BaktiyarBr/ElectronyConstructor/CosmosBoard/CosmosBoard.kicad_pcb

## KiCad design CosmosBoard/CosmosBoard.kicad_pcb (2024-06-29)

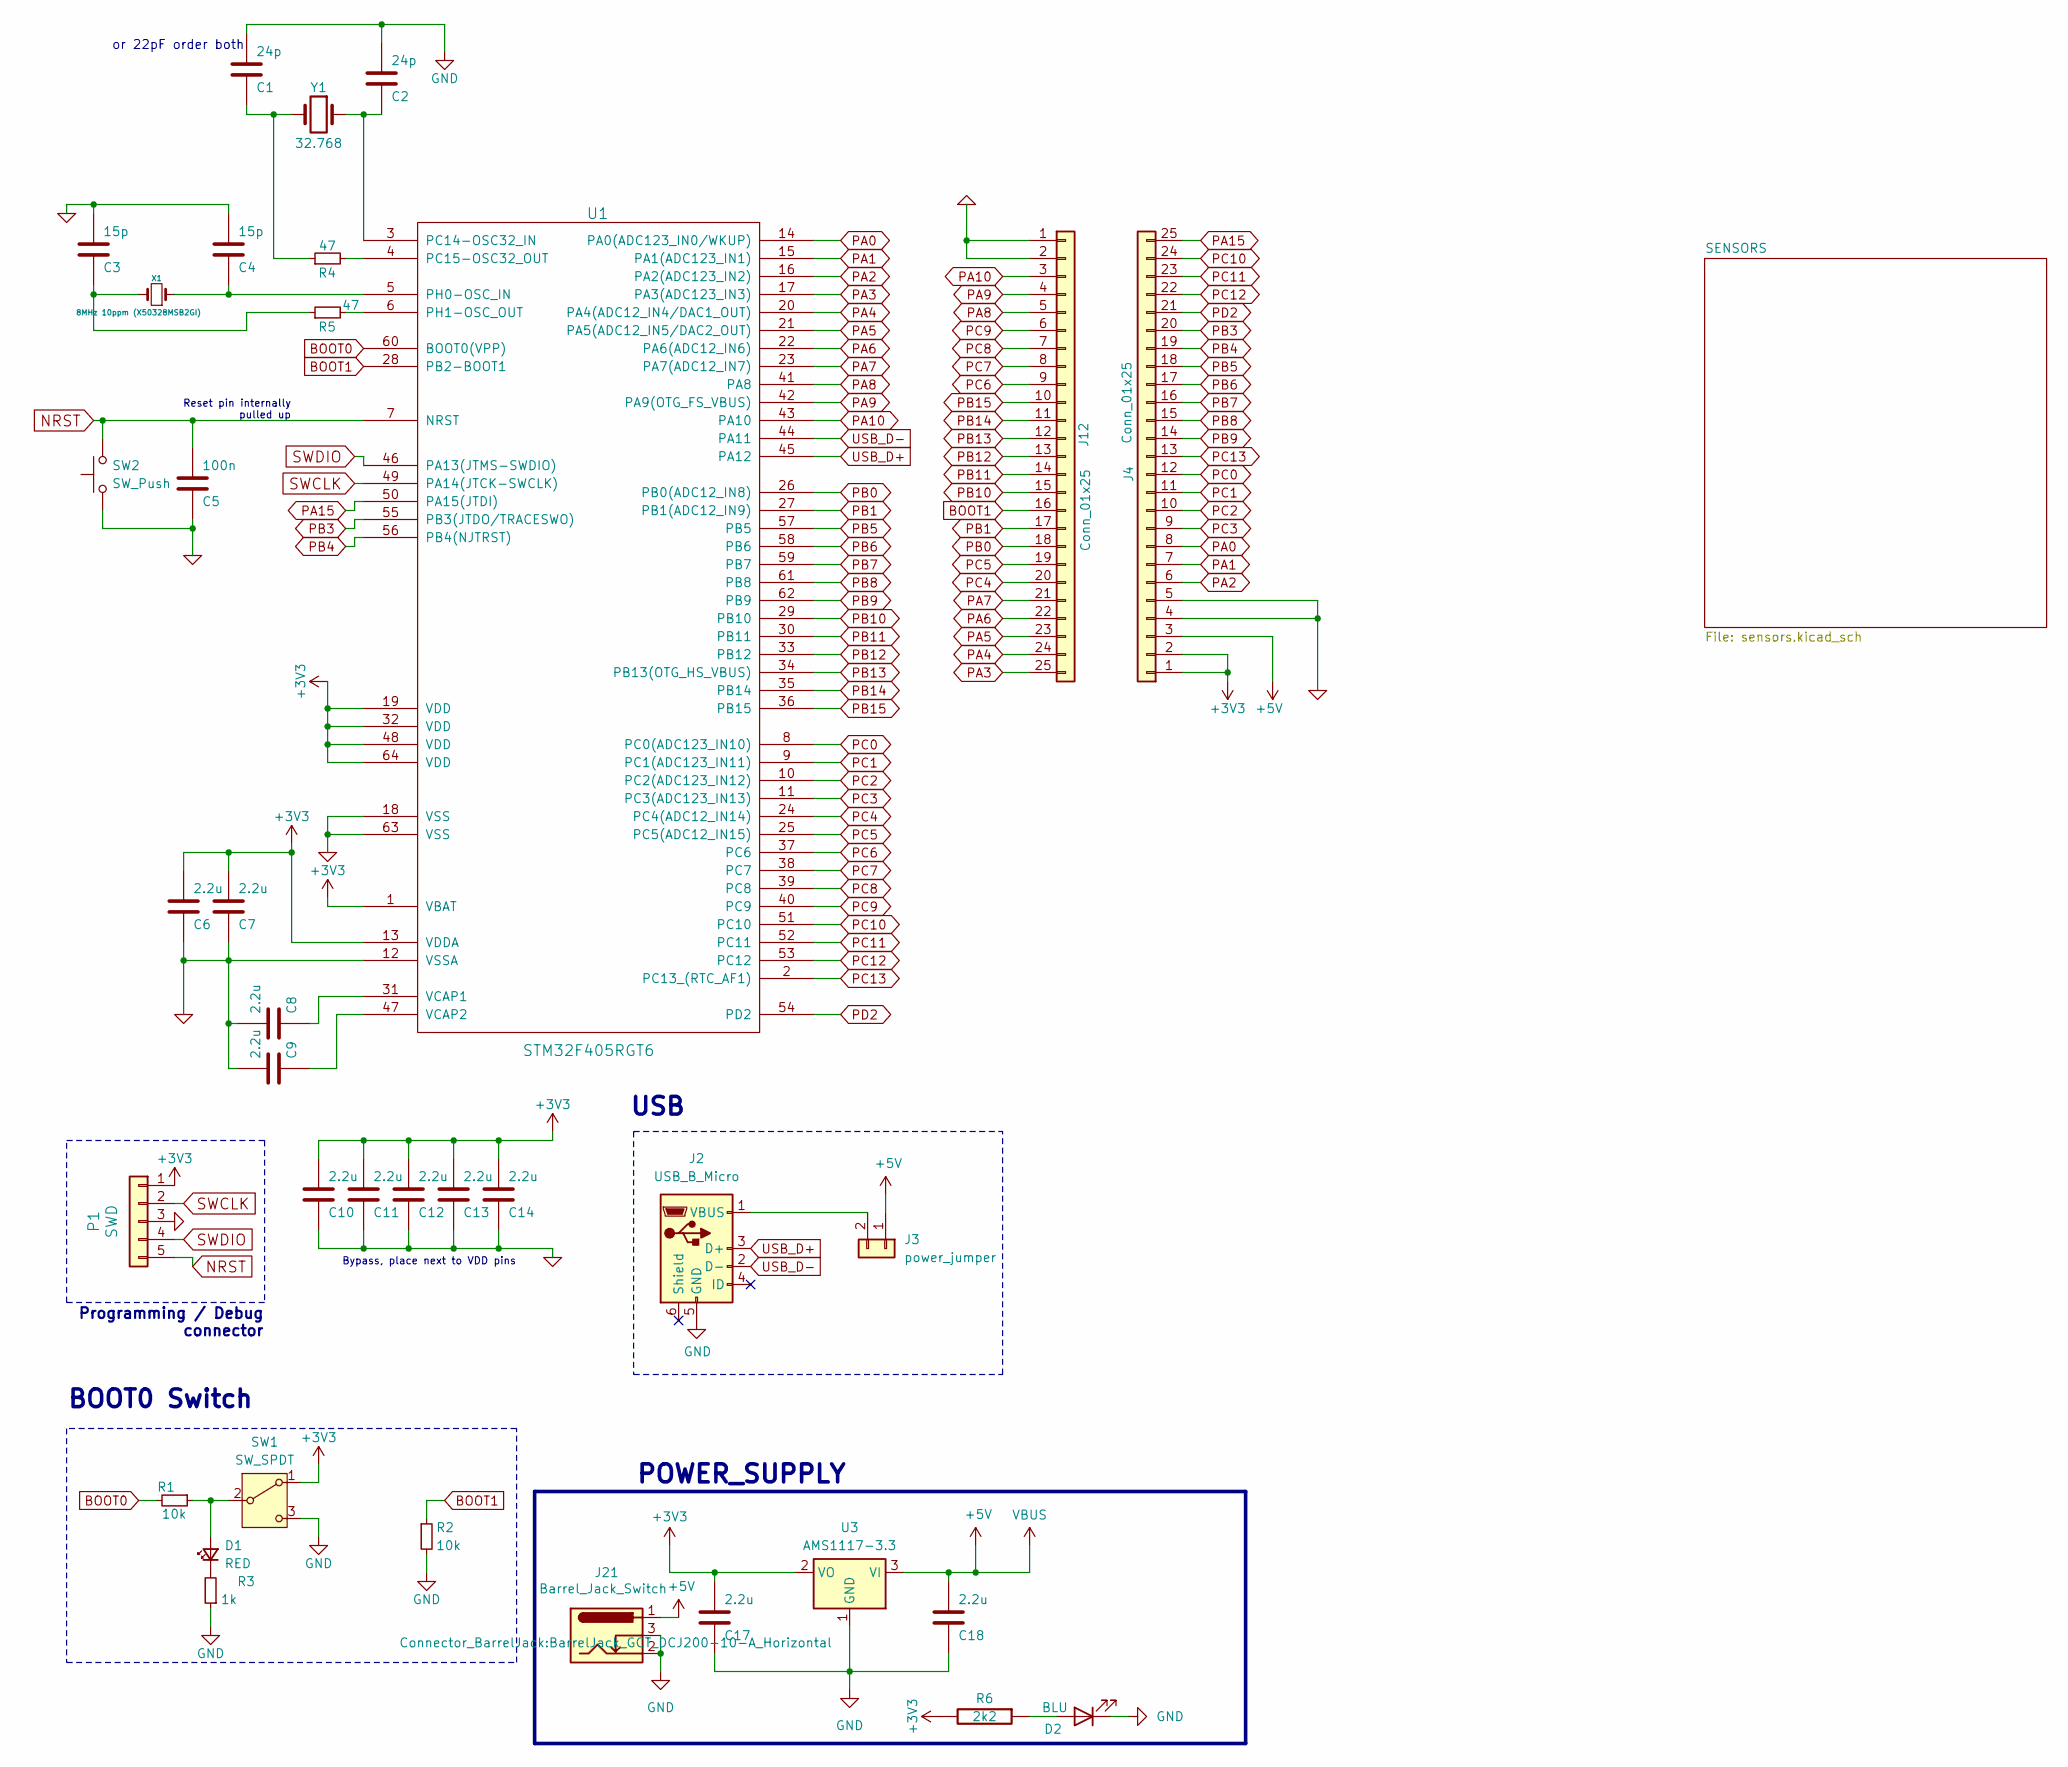
[picture p1: schematic CosmosBoard.kicad_sch]

Parts:
C1, C2: 24p; C_0603_1608Metric
C3, C4: 15p; C_0603_1608Metric
C5: 100n; C_0603_1608Metric
C6, C7, C8, C9, C10, C11, C12, C13, C14, C17, C18: 2.2u; C_0603_1608Metric
D1: RED; LED_0603_1608Metric; LCSC Part # C2286
D2: BLU; LED_0603_1608Metric
J2: USB_B_Micro; USB_Mini-B_Lumberg_2486_01_Horizontal
J3: power_jumper; PinHeader_1x02_P2.54mm_Vertical
J4, J12: Conn_01x25; PinHeader_1x25_P2.54mm_Vertical
J21: Barrel_Jack_Switch; BarrelJack_GCT_DCJ200-10-A_Horizontal
P1: SWD; PinHeader_1x05_P2.54mm_Vertical
R1, R2: 10k; R_0603_1608Metric_Pad0.98x0.95mm_HandSolder; LCSC Part # C25744
R3: 1k; R_0603_1608Metric_Pad0.98x0.95mm_HandSolder; LCSC Part # C21190
R4, R5: 47; R_0603_1608Metric_Pad0.98x0.95mm_HandSolder; LCSC Part # C25118
R6: 2k2; R_0603_1608Metric_Pad0.98x0.95mm_HandSolder
SW1: SW_SPDT; SW_SPDT_PCM12
SW2: SW_Push; SW_Push_SPST_NO_Alps_SKRK
U1: STM32F405RGT6; LQFP-64_10x10mm_P0.5mm
U3: AMS1117-3.3; SOT-223-3_TabPin2
X1: 8MHz 10ppm (X50328MSB2GI); Crystal_SMD_5032-2Pin_5.0x3.2mm; mfg# ABM3B-8.0-10-1UT
Y1: 32.768; Crystal_SMD_3215-2Pin_3.2x1.5mm

Connections:
+3V3: C6.2, C7.2, C10.2, C11.2, C12.2, C13.2, C14.2, C17.2, J4.1, J4.2, P1.1, R6.2, SW1.1 (A), U1.1 (VBAT), U1.13 (VDDA), U1.19 (VDD), U1.32 (VDD), U1.48 (VDD), U1.64 (VDD), U3.2 (VO); also elsewhere on the board
+5V: C18.2, J3.1, J4.3, J21.1, U3.3 (VI); also elsewhere on the board
BOOT0: R1.2, U1.60 (BOOT0(VPP))
BOOT1: J12.16, R2.1, U1.28 (PB2-BOOT1)
GND: C1.2, C2.2, C3.2, C4.2, C5.1, C6.1, C7.1, C8.2, C9.2, C10.1, C11.1, C12.1, C13.1, C14.1, C17.1, C18.1, D2.1 (K), J2.5 (GND), J4.4, J4.5, J12.1, J12.2, J21.2, J21.3, P1.3, R2.2, R3.1, SW1.3 (C), SW2.1, U1.12 (VSSA), U1.18 (VSS), U1.63 (VSS), U3.1 (GND); also elsewhere on the board
NRST: C5.2, P1.5, SW2.2, U1.7 (NRST)
unnamed: C1.1, R4.1, Y1.2
unnamed: C3.1, R5.1, X1.2
unnamed: D1.2 (A), R1.1, SW1.2 (B)
unnamed: D1.1 (K), R3.2
unnamed: D2.2 (A), R6.1
unnamed: J2.1 (VBUS), J3.2
unnamed: C2.1, U1.3 (PC14-OSC32_IN), Y1.1
unnamed: R4.2, U1.4 (PC15-OSC32_OUT)
unnamed: C4.1, U1.5 (PH0-OSC_IN), X1.1
unnamed: R5.2, U1.6 (PH1-OSC_OUT)
unnamed: C8.1, U1.31 (VCAP1)
unnamed: C9.1, U1.47 (VCAP2)
PA0: J4.8, U1.14 (PA0(ADC123_IN0/WKUP))
PA1: J4.7, U1.15 (PA1(ADC123_IN1))
PA2: J4.6, U1.16 (PA2(ADC123_IN2))
PA3: J12.25, U1.17 (PA3(ADC123_IN3))
PA4: J12.24, U1.20 (PA4(ADC12_IN4/DAC1_OUT))
PA5: J12.23, U1.21 (PA5(ADC12_IN5/DAC2_OUT))
PA6: J12.22, U1.22 (PA6(ADC12_IN6))
PA7: J12.21, U1.23 (PA7(ADC12_IN7))
PA8: J12.5, U1.41 (PA8)
PA9: J12.4, U1.42 (PA9(OTG_FS_VBUS))
PA10: J12.3, U1.43 (PA10)
PA15: J4.25, U1.50 (PA15(JTDI))
PB0: J12.18, U1.26 (PB0(ADC12_IN8))
PB1: J12.17, U1.27 (PB1(ADC12_IN9))
PB3: J4.20, U1.55 (PB3(JTDO/TRACESWO))
PB4: J4.19, U1.56 (PB4(NJTRST))
PB5: J4.18, U1.57 (PB5)
PB6: J4.17, U1.58 (PB6)
PB7: J4.16, U1.59 (PB7)
PB8: J4.15, U1.61 (PB8)
PB9: J4.14, U1.62 (PB9)
PB10: J12.15, U1.29 (PB10)
PB11: J12.14, U1.30 (PB11)
PB12: J12.13, U1.33 (PB12)
PB13: J12.12, U1.34 (PB13(OTG_HS_VBUS))
PB14: J12.11, U1.35 (PB14)
PB15: J12.10, U1.36 (PB15)
PC0: J4.12, U1.8 (PC0(ADC123_IN10))
PC1: J4.11, U1.9 (PC1(ADC123_IN11))
PC2: J4.10, U1.10 (PC2(ADC123_IN12))
PC3: J4.9, U1.11 (PC3(ADC123_IN13))
PC4: J12.20, U1.24 (PC4(ADC12_IN14))
PC5: J12.19, U1.25 (PC5(ADC12_IN15))
PC6: J12.9, U1.37 (PC6)
PC7: J12.8, U1.38 (PC7)
PC8: J12.7, U1.39 (PC8)
PC9: J12.6, U1.40 (PC9)
PC10: J4.24, U1.51 (PC10)
PC11: J4.23, U1.52 (PC11)
PC12: J4.22, U1.53 (PC12)
PC13: J4.13, U1.2 (PC13_(RTC_AF1))
PD2: J4.21, U1.54 (PD2)
SWCLK: P1.2, U1.49 (PA14(JTCK-SWCLK))
SWDIO: P1.4, U1.46 (PA13(JTMS-SWDIO))
USB_D+: J2.3 (D+), U1.45 (PA12)
USB_D-: J2.2 (D-), U1.44 (PA11)

Notes on the sheet:
USB
POWER_SUPPLY
BOOT0 Switch
Reset pin internally pulled up
Programming / Debug connector
Bypass, place next to VDD pins
or 22pF order both

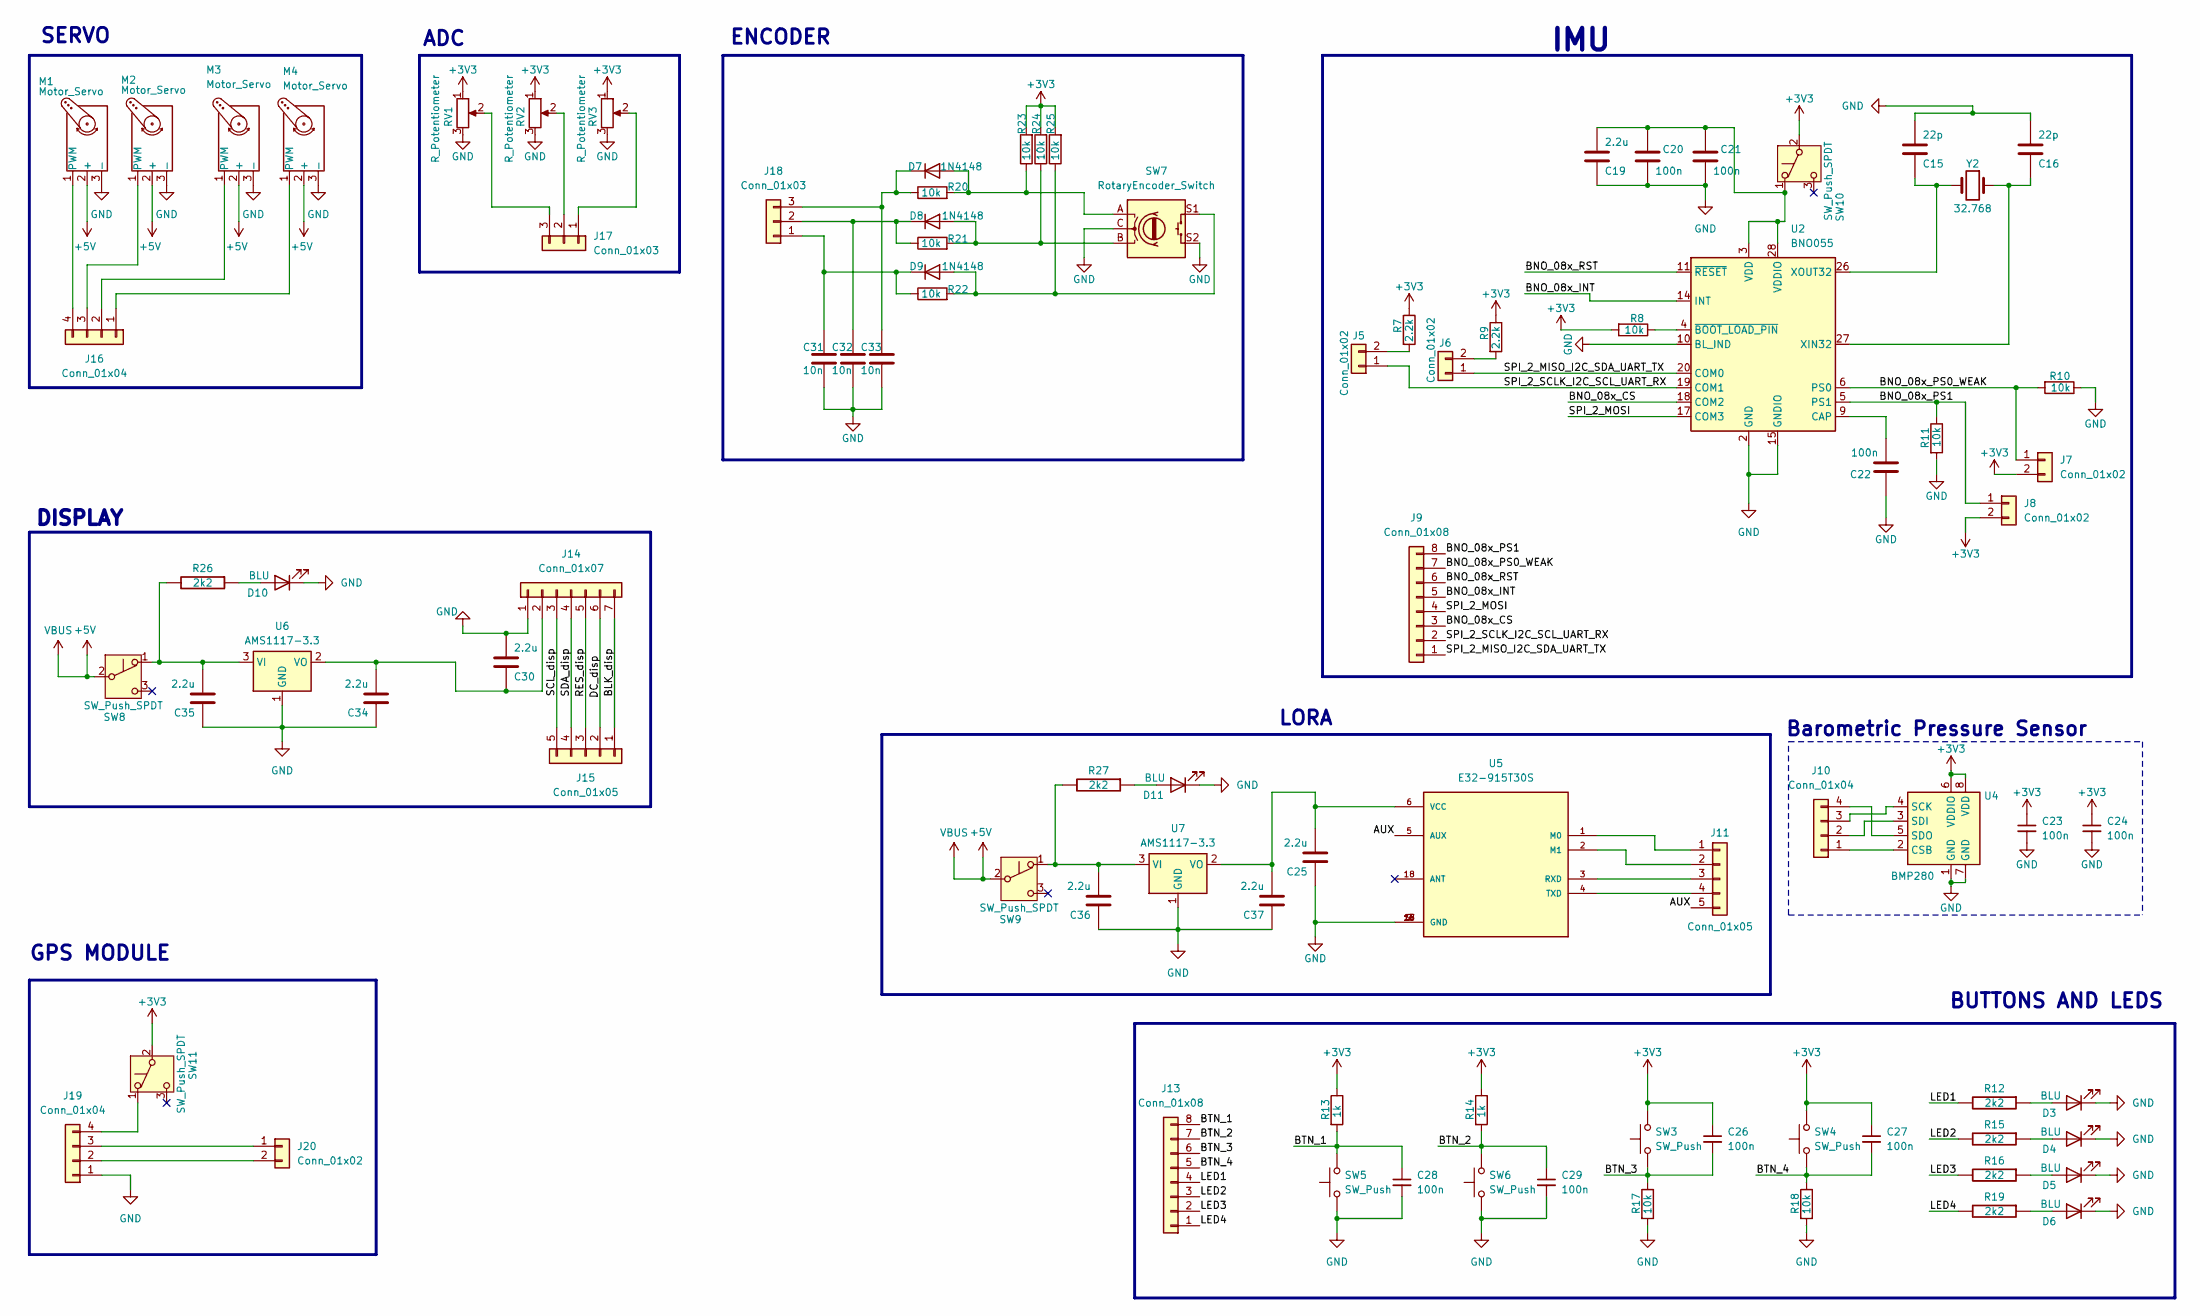
[picture p2: schematic sensors.kicad_sch]

Parts:
C15, C16: 22p; C_0603_1608Metric
C19, C25, C30, C34, C35, C36, C37: 2.2u; C_0603_1608Metric
C20, C21, C22: 100n; C_0603_1608Metric
C23, C24: 100n; C_0402_1005Metric; LCSC Part # C1525
C26, C27, C28, C29: 100n; C_0603_1608Metric; LCSC Part # C1525
C31, C32, C33: 10n; C_0603_1608Metric
D3, D4, D5, D6, D10, D11: BLU; LED_0603_1608Metric
D7, D8, D9: 1N4148; D_DO-35_SOD27_P7.62mm_Horizontal
J5, J6, J7, J8, J20: Conn_01x02; PinHeader_1x02_P2.54mm_Vertical
J9, J13: Conn_01x08; PinHeader_1x08_P2.54mm_Vertical
J10, J16, J19: Conn_01x04; PinHeader_1x04_P2.54mm_Vertical
J11, J15: Conn_01x05; PinHeader_1x05_P2.54mm_Vertical
J14: Conn_01x07; PinHeader_1x07_P2.54mm_Vertical
J17, J18: Conn_01x03; PinHeader_1x03_P2.54mm_Vertical
M1, M2, M3, M4: Motor_Servo; PinHeader_1x03_P2.54mm_Vertical
R7, R9: 2.2k; R_0603_1608Metric_Pad0.98x0.95mm_HandSolder
R8, R10, R11, R17, R18, R20, R21, R22, R23, R24, R25: 10k; R_0603_1608Metric_Pad0.98x0.95mm_HandSolder
R12, R15, R16, R19, R26, R27: 2k2; R_0603_1608Metric_Pad0.98x0.95mm_HandSolder
R13, R14: 1k; R_0603_1608Metric_Pad0.98x0.95mm_HandSolder
RV1, RV2, RV3: R_Potentiometer; Potentiometer_TT_P0915N
SW3, SW4, SW5, SW6: SW_Push; SW_PUSH-12mm
SW7: RotaryEncoder_Switch; RotaryEncoder_Alps_EC11E-Switch_Vertical_H20mm_CircularMoun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
SW8, SW9, SW10, SW11: SW_Push_SPDT; SW_Slide-03_Wuerth-WS-SLTV_10x2.5x6.4_P2.54mm
U2: BNO055; LGA-28_5.2x3.8mm_P0.5mm
U4: BMP280; Bosch_LGA-8_2x2.5mm_P0.65mm_ClockwisePinNumbering; LCSC Part # C233787
U5: E32-915T30S; XCVR_E22-900T30S; PARTREV 1.4
U6, U7: AMS1117-3.3; SOT-223-3_TabPin2
Y2: 32.768; Crystal_SMD_3215-2Pin_3.2x1.5mm

Connections:
+3V3: C23.1, C24.1, C26.1, C27.1, J7.2, J8.2, R7.1, R8.2, R9.1, R13.1, R14.1, R23.2, R24.2, R25.2, RV1.1, RV2.1, RV3.1, SW3.2, SW4.2, SW10.2 (B), SW11.2 (B), U4.6 (VDDIO), U4.8 (VDD); also elsewhere on the board
+5V: M1.2 (+), M2.2 (+), M3.2 (+), M4.2 (+), SW8.2 (B), SW9.2 (B); also elsewhere on the board
/SENSORS/AUX: J11.5, U5.5 (AUX)
/SENSORS/BLK_disp: J14.7, J15.1
/SENSORS/BNO_08x_CS: J9.3, U2.18 (COM2)
/SENSORS/BNO_08x_INT: J9.5, U2.14 (INT)
/SENSORS/BNO_08x_PS0_WEAK: J7.1, J9.7, R10.2, U2.6 (PS0)
/SENSORS/BNO_08x_PS1: J8.1, J9.8, R11.1, U2.5 (PS1)
/SENSORS/BNO_08x_RST: J9.6, U2.11 (~RESET)
/SENSORS/BTN_1: C28.1, J13.8, R13.2, SW5.2
/SENSORS/BTN_2: C29.1, J13.7, R14.2, SW6.2
/SENSORS/BTN_3: C26.2, J13.6, R17.1, SW3.1
/SENSORS/BTN_4: C27.2, J13.5, R18.1, SW4.1
/SENSORS/DC_disp: J14.6, J15.2
/SENSORS/LED1: J13.4, R12.2
/SENSORS/LED2: J13.3, R15.2
/SENSORS/LED3: J13.2, R16.2
/SENSORS/LED4: J13.1, R19.2
/SENSORS/RES_disp: J14.5, J15.3
/SENSORS/SCL_disp: J14.3, J15.5
/SENSORS/SDA_disp: J14.4, J15.4
/SENSORS/SPI_2_MISO_I2C_SDA_UART_TX: J6.1, J9.1, U2.20 (COM0)
/SENSORS/SPI_2_MOSI: J9.4, U2.17 (COM3)
/SENSORS/SPI_2_SCLK_I2C_SCL_UART_RX: J5.1, J9.2, U2.19 (COM1)
GND: C15.2, C16.2, C19.1, C20.2, C21.2, C22.1, C23.2, C24.2, C25.1, C28.2, C29.2, C30.2, C31.2, C32.2, C33.2, C34.1, C35.1, C36.1, C37.1, D3.1 (K), D4.1 (K), D5.1 (K), D6.1 (K), D10.1 (K), D11.1 (K), J14.1, J19.1, M1.3 (-), M2.3 (-), M3.3 (-), M4.3 (-), R10.1, R11.2, R17.2, R18.2, RV1.3, RV2.3, RV3.3, SW5.1, SW6.1, SW7.C, SW7.S2, U2.2 (GND), U2.10 (BL_IND), U2.15 (GNDIO), U2.16 (GNDIO), U2.25 (GNDIO), U4.1 (GND), U4.7 (GND), U5.7 (GND), U5.9 (GND), U5.15 (GND), U5.16 (GND), U5.17 (GND), U6.1 (GND), U7.1 (GND); also elsewhere on the board
unnamed: D3.2 (A), R12.1
unnamed: D4.2 (A), R15.1
unnamed: D5.2 (A), R16.1
unnamed: D6.2 (A), R19.1
unnamed: D7.2 (A), R20.2, R23.1, SW7.A
unnamed: C33.1, D7.1 (K), J18.3, R20.1
unnamed: D8.2 (A), R21.2, R24.1, SW7.B
unnamed: C32.1, D8.1 (K), J18.2, R21.1
unnamed: D9.2 (A), R22.2, R25.1, SW7.S1
unnamed: C31.1, D9.1 (K), J18.1, R22.1
unnamed: D10.2 (A), R26.1
unnamed: D11.2 (A), R27.1
unnamed: J5.2, R7.2
unnamed: J6.2, R9.2
unnamed: J10.1, U4.2 (CSB)
unnamed: J10.2, U4.3 (SDI)
unnamed: J10.3, U4.4 (SCK)
unnamed: J10.4, U4.5 (SDO)
unnamed: J11.1, U5.1 (M0)
unnamed: J11.2, U5.2 (M1)
unnamed: J11.3, U5.3 (RXD)
unnamed: J11.4, U5.4 (TXD)
unnamed: C30.1, C34.2, J14.2, U6.2 (VO)
unnamed: J16.1, M4.1 (PWM)
unnamed: J16.2, M3.1 (PWM)
unnamed: J16.3, M2.1 (PWM)
unnamed: J16.4, M1.1 (PWM)
unnamed: J17.1, RV3.2
unnamed: J17.2, RV2.2
unnamed: J17.3, RV1.2
unnamed: J19.2, J20.2
unnamed: J19.3, J20.1
unnamed: J19.4, SW11.1 (A)
unnamed: C35.2, R26.2, SW8.1 (A), U6.3 (VI)
unnamed: C36.2, R27.2, SW9.1 (A), U7.3 (VI)
unnamed: C19.2, C20.1, C21.1, SW10.1 (A), U2.3 (VDD), U2.28 (VDDIO)
unnamed: C22.2, U2.9 (CAP)
unnamed: C16.1, U2.27 (XIN32), Y2.1
unnamed: C15.1, U2.26 (XOUT32), Y2.2
unnamed: R8.1, U2.4 (~BOOT_LOAD_PIN)
unnamed: C25.2, C37.2, U5.6 (VCC), U7.2 (VO)

Notes on the sheet:
GPS MODULE
DISPLAY
Barometric Pressure Sensor
IMU
ADC
SERVO
BUTTONS AND LEDS
ENCODER
LORA

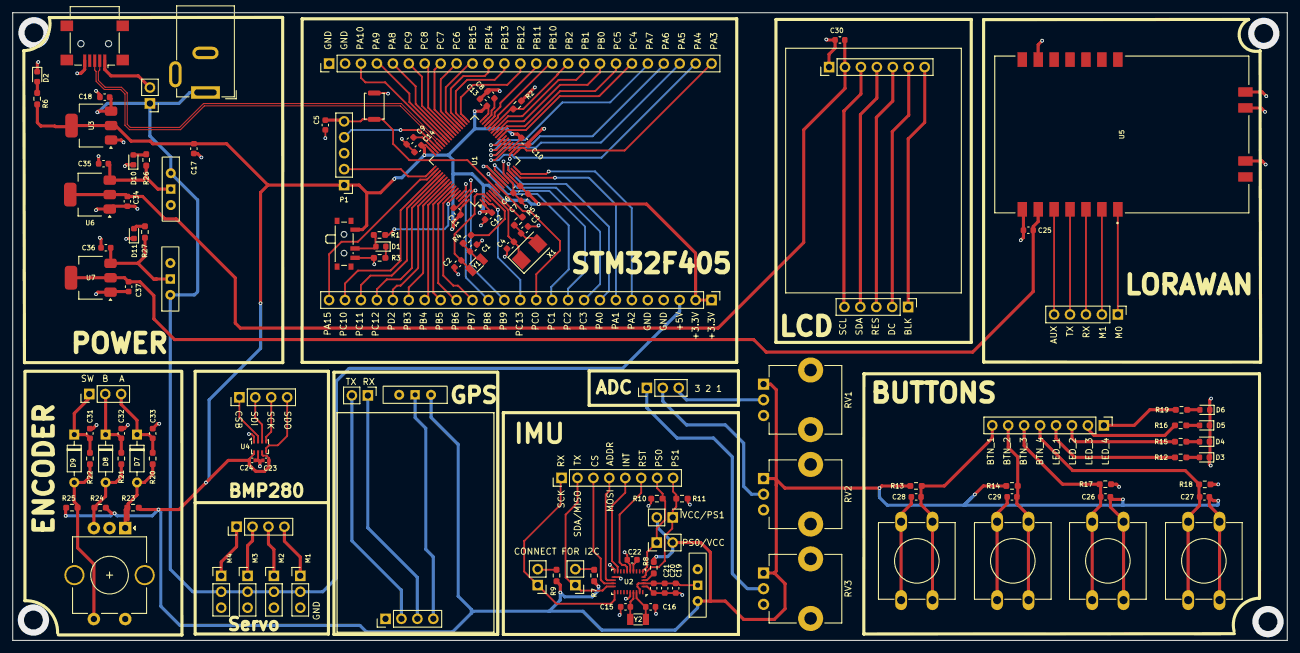
[picture p3: board CosmosBoard.kicad_pcb from above]

Board: 4 copper layers, 203.2 x 100.0 mm, 124 parts (0 on the bottom side), 127 nets.
